Abean2k/Wiz-lite/WizLite_Production/WizLite_V1_bom.csv

Designator | Footprint | Quantity | Value | LCSC Part #
C1, C2 | 0805 | 2 | 100n
C3, C4 | 1210 | 2 | 47uF
J1 | USB_C_Receptacle_HCTL_HC-TYPE-C-16P-01A | 1 | USB_C_Receptacle_USB2.0_16P
R1, R10, R11, R2, R3, R4, R7, R8, R9 | 0805 | 9 | 10k
R12, R13 | 0805 | 2 | 330
R5, R6 | 0805 | 2 | 5.1k
SW1, SW2, SW3, SW4, SW5, SW6, SW7, SW8, SW9 | SW_SPST_TS-1088-xR020 | 9 | SW_Push
TP1, TP2, TP3, TP4 | TestPoint_Pad_D1.0mm | 4 | TestPoint
U1 | SOIC-16_3.9x9.9mm_P1.27mm | 1 | CH552G
U10, U100, U101, U102, U103, U104, U105, U106, U107, U108, U109, U11, U110, U111, U112, U113, U114, U115, U116, U117, U118, U119, U12, U120, U121, U122, U123, U124, U125, U126, U127, U13, U14, U15, U16, U17, U18, U19, U2, U20, U21, U22, U23, U24, U25, U26, U27, U28, U29, U3, U30, U31, U32, U33, U34, U35, U36, U37, U38, U39, U4, U40, U41, U42, U43, U44, U45, U46, U47, U48, U49, U5, U50, U51, U52, U53, U54, U55, U56, U57, U58, U59, U6, U60, U61, U62, U63, U64, U65, U66, U67, U68, U69, U7, U70, U71, U72, U73, U74, U75, U76, U77, U78, U79, U8, U80, U81, U82, U83, U84, U85, U86, U87, U88, U89, U9, U90, U91, U92, U93, U94, U95, U96, U97, U98, U99 | LED-SMD_4P-L2.0-W1.8_XL-0807RGBC-WS2812B-S | 126 | XL-0807RGBC-WS2812B-S | C41413181
