Abean2k/Wiz-lite/WizLite PCB/WizLite.kicad_pcb

## KiCad design WizLite PCB/WizLite.kicad_pcb (2026-10-24)

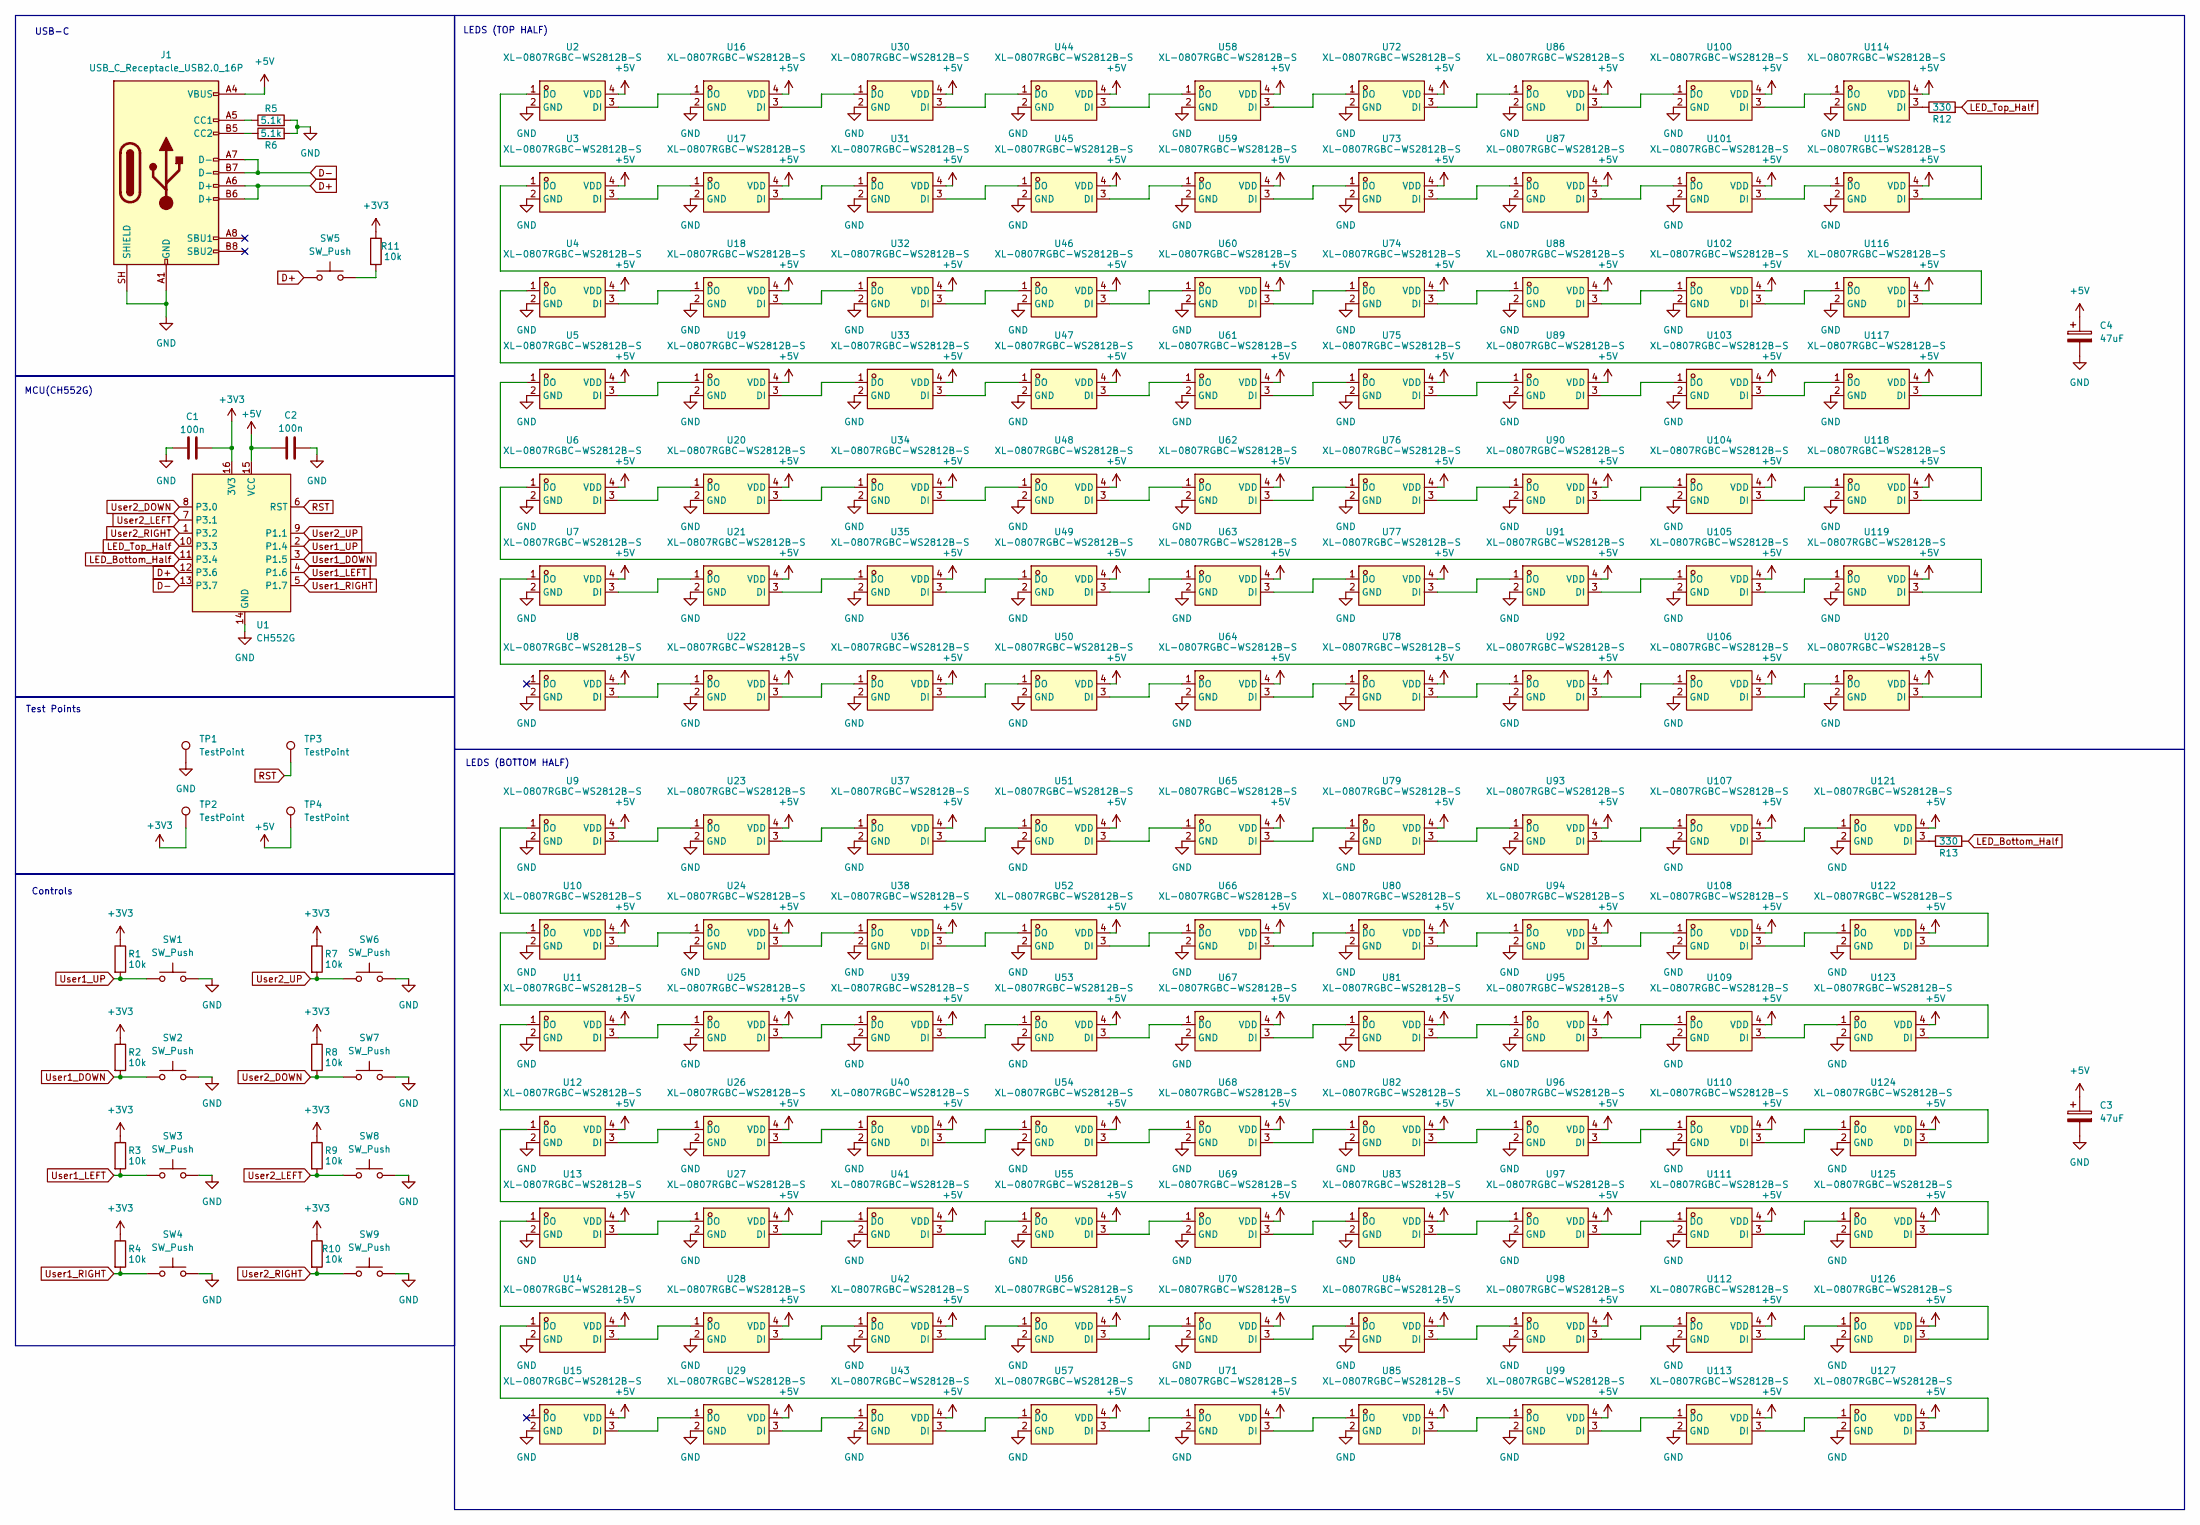
[picture p1: schematic WizLite.kicad_sch]

Parts:
C1, C2: 100n; C_0805_2012Metric_Pad1.18x1.45mm_HandSolder
C3, C4: 47uF; C_1210_3225Metric_Pad1.33x2.70mm_HandSolder
J1: USB_C_Receptacle_USB2.0_16P; USB_C_Receptacle_HCTL_HC-TYPE-C-16P-01A
R1, R2, R3, R4, R7, R8, R9, R10, R11: 10k; R_0805_2012Metric_Pad1.20x1.40mm_HandSolder
R5, R6: 5.1k; R_0805_2012Metric_Pad1.20x1.40mm_HandSolder
R12, R13: 330; R_0805_2012Metric_Pad1.20x1.40mm_HandSolder
SW1, SW2, SW3, SW4, SW5, SW6, SW7, SW8, SW9: SW_Push; SW_SPST_TS-1088-xR020
TP1, TP2, TP3, TP4: TestPoint; TestPoint_Pad_D1.0mm
U1: CH552G; SOIC-16_3.9x9.9mm_P1.27mm
U2, U3, U4, U5, U6, U7, U8, U9, U10, U11, U12, U13, U14, U15, U16, U17, U18, U19, U20, U21, U22, U23, U24, U25, U26, U27, U28, U29, U30, U31, U32, U33, U34, U35, U36, U37, U38, U39, U40, U41, U42, U43, U44, U45, U46, U47, U48, U49, U50, U51, U52, U53, U54, U55, U56, U57, U58, U59, U60, U61, U62, U63, U64, U65, U66, U67, U68, U69, U70, U71, U72, U73, U74, U75, U76, U77, U78, U79, U80, U81, U82, U83, U84, U85, U86, U87, U88, U89, U90, U91, U92, U93, U94, U95, U96, U97, U98, U99, U100, U101, U102, U103, U104, U105, U106, U107, U108, U109, U110, U111, U112, U113, U114, U115, U116, U117, U118, U119, U120, U121, U122, U123, U124, U125, U126, U127: XL-0807RGBC-WS2812B-S; LED-SMD_4P-L2.0-W1.8_XL-0807RGBC-WS2812B-S; MPN XL-0807RGBC-2812B-S; LCSC Part C41413181

Connections:
+3V3: C1.1, R1.1, R2.1, R3.1, R4.1, R7.1, R8.1, R9.1, R10.1, R11.1, TP2.1 (1_1), U1.16 (3V3)
+5V: C2.2, C3.1, C4.1, J1.A4 (VBUS), J1.A9 (VBUS), J1.B4 (VBUS), J1.B9 (VBUS), TP4.1 (1_1), U1.15 (VCC), U2.4 (VDD), U3.4 (VDD), U4.4 (VDD), U5.4 (VDD), U6.4 (VDD), U7.4 (VDD), U8.4 (VDD), U9.4 (VDD), U10.4 (VDD), U11.4 (VDD), U12.4 (VDD), U13.4 (VDD), U14.4 (VDD), U15.4 (VDD), U16.4 (VDD), U17.4 (VDD), U18.4 (VDD), U19.4 (VDD), U20.4 (VDD), U21.4 (VDD), U22.4 (VDD), U23.4 (VDD), U24.4 (VDD), U25.4 (VDD), U26.4 (VDD), U27.4 (VDD), U28.4 (VDD), U29.4 (VDD), U30.4 (VDD), U31.4 (VDD), U32.4 (VDD), U33.4 (VDD), U34.4 (VDD), U35.4 (VDD), U36.4 (VDD), U37.4 (VDD), U38.4 (VDD), U39.4 (VDD), U40.4 (VDD), U41.4 (VDD), U42.4 (VDD), U43.4 (VDD), U44.4 (VDD), U45.4 (VDD), U46.4 (VDD), U47.4 (VDD), U48.4 (VDD), U49.4 (VDD), U50.4 (VDD), U51.4 (VDD), U52.4 (VDD), U53.4 (VDD), U54.4 (VDD), U55.4 (VDD), U56.4 (VDD), U57.4 (VDD), U58.4 (VDD), U59.4 (VDD), U60.4 (VDD), U61.4 (VDD), U62.4 (VDD), U63.4 (VDD), U64.4 (VDD), U65.4 (VDD), U66.4 (VDD), U67.4 (VDD), U68.4 (VDD), U69.4 (VDD), U70.4 (VDD), U71.4 (VDD), U72.4 (VDD), U73.4 (VDD), U74.4 (VDD), U75.4 (VDD), U76.4 (VDD), U77.4 (VDD), U78.4 (VDD), U79.4 (VDD), U80.4 (VDD), U81.4 (VDD), U82.4 (VDD), U83.4 (VDD), U84.4 (VDD), U85.4 (VDD), U86.4 (VDD), U87.4 (VDD), U88.4 (VDD), U89.4 (VDD), U90.4 (VDD), U91.4 (VDD), U92.4 (VDD), U93.4 (VDD), U94.4 (VDD), U95.4 (VDD), U96.4 (VDD), U97.4 (VDD), U98.4 (VDD), U99.4 (VDD), U100.4 (VDD), U101.4 (VDD), U102.4 (VDD), U103.4 (VDD), U104.4 (VDD), U105.4 (VDD), U106.4 (VDD), U107.4 (VDD), U108.4 (VDD), U109.4 (VDD), U110.4 (VDD), U111.4 (VDD), U112.4 (VDD), U113.4 (VDD), U114.4 (VDD), U115.4 (VDD), U116.4 (VDD), U117.4 (VDD), U118.4 (VDD), U119.4 (VDD), U120.4 (VDD), U121.4 (VDD), U122.4 (VDD), U123.4 (VDD), U124.4 (VDD), U125.4 (VDD), U126.4 (VDD), U127.4 (VDD)
D+: J1.A6 (D+), J1.B6 (D+), SW5.1, U1.12 (P3.6)
D-: J1.A7 (D-), J1.B7 (D-), U1.13 (P3.7)
GND: C1.2, C2.1, C3.2, C4.2, J1.A1 (GND), J1.A12 (GND), J1.B1 (GND), J1.B12 (GND), J1.SH (SHIELD), R5.2, R6.2, SW1.2, SW2.2, SW3.2, SW4.2, SW6.2, SW7.2, SW8.2, SW9.2, TP1.1 (1_1), U1.14 (GND), U2.2 (GND), U3.2 (GND), U4.2 (GND), U5.2 (GND), U6.2 (GND), U7.2 (GND), U8.2 (GND), U9.2 (GND), U10.2 (GND), U11.2 (GND), U12.2 (GND), U13.2 (GND), U14.2 (GND), U15.2 (GND), U16.2 (GND), U17.2 (GND), U18.2 (GND), U19.2 (GND), U20.2 (GND), U21.2 (GND), U22.2 (GND), U23.2 (GND), U24.2 (GND), U25.2 (GND), U26.2 (GND), U27.2 (GND), U28.2 (GND), U29.2 (GND), U30.2 (GND), U31.2 (GND), U32.2 (GND), U33.2 (GND), U34.2 (GND), U35.2 (GND), U36.2 (GND), U37.2 (GND), U38.2 (GND), U39.2 (GND), U40.2 (GND), U41.2 (GND), U42.2 (GND), U43.2 (GND), U44.2 (GND), U45.2 (GND), U46.2 (GND), U47.2 (GND), U48.2 (GND), U49.2 (GND), U50.2 (GND), U51.2 (GND), U52.2 (GND), U53.2 (GND), U54.2 (GND), U55.2 (GND), U56.2 (GND), U57.2 (GND), U58.2 (GND), U59.2 (GND), U60.2 (GND), U61.2 (GND), U62.2 (GND), U63.2 (GND), U64.2 (GND), U65.2 (GND), U66.2 (GND), U67.2 (GND), U68.2 (GND), U69.2 (GND), U70.2 (GND), U71.2 (GND), U72.2 (GND), U73.2 (GND), U74.2 (GND), U75.2 (GND), U76.2 (GND), U77.2 (GND), U78.2 (GND), U79.2 (GND), U80.2 (GND), U81.2 (GND), U82.2 (GND), U83.2 (GND), U84.2 (GND), U85.2 (GND), U86.2 (GND), U87.2 (GND), U88.2 (GND), U89.2 (GND), U90.2 (GND), U91.2 (GND), U92.2 (GND), U93.2 (GND), U94.2 (GND), U95.2 (GND), U96.2 (GND), U97.2 (GND), U98.2 (GND), U99.2 (GND), U100.2 (GND), U101.2 (GND), U102.2 (GND), U103.2 (GND), U104.2 (GND), U105.2 (GND), U106.2 (GND), U107.2 (GND), U108.2 (GND), U109.2 (GND), U110.2 (GND), U111.2 (GND), U112.2 (GND), U113.2 (GND), U114.2 (GND), U115.2 (GND), U116.2 (GND), U117.2 (GND), U118.2 (GND), U119.2 (GND), U120.2 (GND), U121.2 (GND), U122.2 (GND), U123.2 (GND), U124.2 (GND), U125.2 (GND), U126.2 (GND), U127.2 (GND)
LED_Bottom_Half: R13.2, U1.11 (P3.4)
LED_Top_Half: R12.2, U1.10 (P3.3)
unnamed: J1.A5 (CC1), R5.1
unnamed: J1.B5 (CC2), R6.1
unnamed: R11.2, SW5.2
unnamed: U10.3 (DI), U24.1 (DO)
unnamed: U10.1 (DO), U123.3 (DI)
unnamed: U11.3 (DI), U25.1 (DO)
unnamed: U11.1 (DO), U124.3 (DI)
unnamed: U12.3 (DI), U26.1 (DO)
unnamed: U12.1 (DO), U125.3 (DI)
unnamed: U13.3 (DI), U27.1 (DO)
unnamed: U14.3 (DI), U28.1 (DO)
unnamed: U15.3 (DI), U29.1 (DO)
unnamed: U16.3 (DI), U30.1 (DO)
unnamed: U2.3 (DI), U16.1 (DO)
unnamed: U17.3 (DI), U31.1 (DO)
unnamed: U3.3 (DI), U17.1 (DO)
unnamed: U18.3 (DI), U32.1 (DO)
unnamed: U4.3 (DI), U18.1 (DO)
unnamed: U19.3 (DI), U33.1 (DO)
unnamed: U5.3 (DI), U19.1 (DO)
unnamed: U20.3 (DI), U34.1 (DO)
unnamed: U6.3 (DI), U20.1 (DO)
unnamed: U21.3 (DI), U35.1 (DO)
unnamed: U7.3 (DI), U21.1 (DO)
unnamed: U22.3 (DI), U36.1 (DO)
unnamed: U8.3 (DI), U22.1 (DO)
unnamed: U23.3 (DI), U37.1 (DO)
unnamed: U9.3 (DI), U23.1 (DO)
unnamed: U24.3 (DI), U38.1 (DO)
unnamed: U25.3 (DI), U39.1 (DO)
unnamed: U26.3 (DI), U40.1 (DO)
unnamed: U27.3 (DI), U41.1 (DO)
unnamed: U28.3 (DI), U42.1 (DO)
unnamed: U29.3 (DI), U43.1 (DO)
unnamed: U30.3 (DI), U44.1 (DO)
unnamed: U31.3 (DI), U45.1 (DO)
unnamed: U32.3 (DI), U46.1 (DO)
unnamed: U33.3 (DI), U47.1 (DO)
unnamed: U34.3 (DI), U48.1 (DO)
unnamed: U35.3 (DI), U49.1 (DO)
unnamed: U36.3 (DI), U50.1 (DO)
unnamed: U37.3 (DI), U51.1 (DO)
unnamed: U38.3 (DI), U52.1 (DO)
unnamed: U39.3 (DI), U53.1 (DO)
unnamed: U40.3 (DI), U54.1 (DO)
unnamed: U41.3 (DI), U55.1 (DO)
unnamed: U42.3 (DI), U56.1 (DO)
unnamed: U43.3 (DI), U57.1 (DO)
unnamed: U44.3 (DI), U58.1 (DO)
unnamed: U45.3 (DI), U59.1 (DO)
unnamed: U46.3 (DI), U60.1 (DO)
unnamed: U47.3 (DI), U61.1 (DO)
unnamed: U48.3 (DI), U62.1 (DO)
unnamed: U49.3 (DI), U63.1 (DO)
unnamed: U50.3 (DI), U64.1 (DO)
unnamed: U51.3 (DI), U65.1 (DO)
unnamed: U52.3 (DI), U66.1 (DO)
unnamed: U53.3 (DI), U67.1 (DO)
unnamed: U54.3 (DI), U68.1 (DO)
unnamed: U55.3 (DI), U69.1 (DO)
unnamed: U56.3 (DI), U70.1 (DO)
unnamed: U57.3 (DI), U71.1 (DO)
unnamed: U58.3 (DI), U72.1 (DO)
unnamed: U59.3 (DI), U73.1 (DO)
unnamed: U60.3 (DI), U74.1 (DO)
unnamed: U61.3 (DI), U75.1 (DO)
unnamed: U62.3 (DI), U76.1 (DO)
unnamed: U63.3 (DI), U77.1 (DO)
unnamed: U64.3 (DI), U78.1 (DO)
unnamed: U65.3 (DI), U79.1 (DO)
unnamed: U66.3 (DI), U80.1 (DO)
unnamed: U67.3 (DI), U81.1 (DO)
unnamed: U68.3 (DI), U82.1 (DO)
unnamed: U69.3 (DI), U83.1 (DO)
unnamed: U70.3 (DI), U84.1 (DO)
unnamed: U71.3 (DI), U85.1 (DO)
unnamed: U72.3 (DI), U86.1 (DO)
unnamed: U73.3 (DI), U87.1 (DO)
unnamed: U74.3 (DI), U88.1 (DO)
unnamed: U75.3 (DI), U89.1 (DO)
unnamed: U76.3 (DI), U90.1 (DO)
unnamed: U77.3 (DI), U91.1 (DO)
unnamed: U78.3 (DI), U92.1 (DO)
unnamed: U79.3 (DI), U93.1 (DO)
unnamed: U80.3 (DI), U94.1 (DO)
unnamed: U81.3 (DI), U95.1 (DO)
unnamed: U82.3 (DI), U96.1 (DO)
unnamed: U83.3 (DI), U97.1 (DO)
unnamed: U84.3 (DI), U98.1 (DO)
unnamed: U85.3 (DI), U99.1 (DO)
unnamed: U100.3 (DI), U114.1 (DO)
unnamed: U86.3 (DI), U100.1 (DO)
unnamed: U101.3 (DI), U115.1 (DO)
unnamed: U87.3 (DI), U101.1 (DO)
unnamed: U102.3 (DI), U116.1 (DO)
unnamed: U88.3 (DI), U102.1 (DO)
unnamed: U103.3 (DI), U117.1 (DO)
unnamed: U89.3 (DI), U103.1 (DO)
unnamed: U104.3 (DI), U118.1 (DO)
unnamed: U90.3 (DI), U104.1 (DO)
unnamed: U105.3 (DI), U119.1 (DO)
unnamed: U91.3 (DI), U105.1 (DO)
unnamed: U106.3 (DI), U120.1 (DO)
unnamed: U92.3 (DI), U106.1 (DO)
unnamed: U107.3 (DI), U121.1 (DO)
unnamed: U93.3 (DI), U107.1 (DO)
unnamed: U108.3 (DI), U122.1 (DO)
unnamed: U94.3 (DI), U108.1 (DO)
unnamed: U109.3 (DI), U123.1 (DO)
unnamed: U95.3 (DI), U109.1 (DO)
unnamed: U110.3 (DI), U124.1 (DO)
unnamed: U96.3 (DI), U110.1 (DO)
unnamed: U111.3 (DI), U125.1 (DO)
unnamed: U97.3 (DI), U111.1 (DO)
unnamed: U112.3 (DI), U126.1 (DO)
unnamed: U98.3 (DI), U112.1 (DO)
unnamed: U113.3 (DI), U127.1 (DO)
unnamed: U99.3 (DI), U113.1 (DO)
unnamed: R12.1, U114.3 (DI)
unnamed: U2.1 (DO), U115.3 (DI)
unnamed: U3.1 (DO), U116.3 (DI)
unnamed: U4.1 (DO), U117.3 (DI)
unnamed: U5.1 (DO), U118.3 (DI)
unnamed: U6.1 (DO), U119.3 (DI)
unnamed: U7.1 (DO), U120.3 (DI)
unnamed: R13.1, U121.3 (DI)
unnamed: U9.1 (DO), U122.3 (DI)
unnamed: U13.1 (DO), U126.3 (DI)
unnamed: U14.1 (DO), U127.3 (DI)
RST: TP3.1 (1_1), U1.6 (RST)
User1_DOWN: R2.2, SW2.1, U1.3 (P1.5)
User1_LEFT: R3.2, SW3.1, U1.4 (P1.6)
User1_RIGHT: R4.2, SW4.1, U1.5 (P1.7)
User1_UP: R1.2, SW1.1, U1.2 (P1.4)
User2_DOWN: R8.2, SW7.1, U1.8 (P3.0)
User2_LEFT: R9.2, SW8.1, U1.7 (P3.1)
User2_RIGHT: R10.2, SW9.1, U1.1 (P3.2)
User2_UP: R7.2, SW6.1, U1.9 (P1.1)

Notes on the sheet:
MCU(CH552G)
Controls
USB-C
LEDS (BOTTOM HALF)
Test Points
LEDS (TOP HALF)

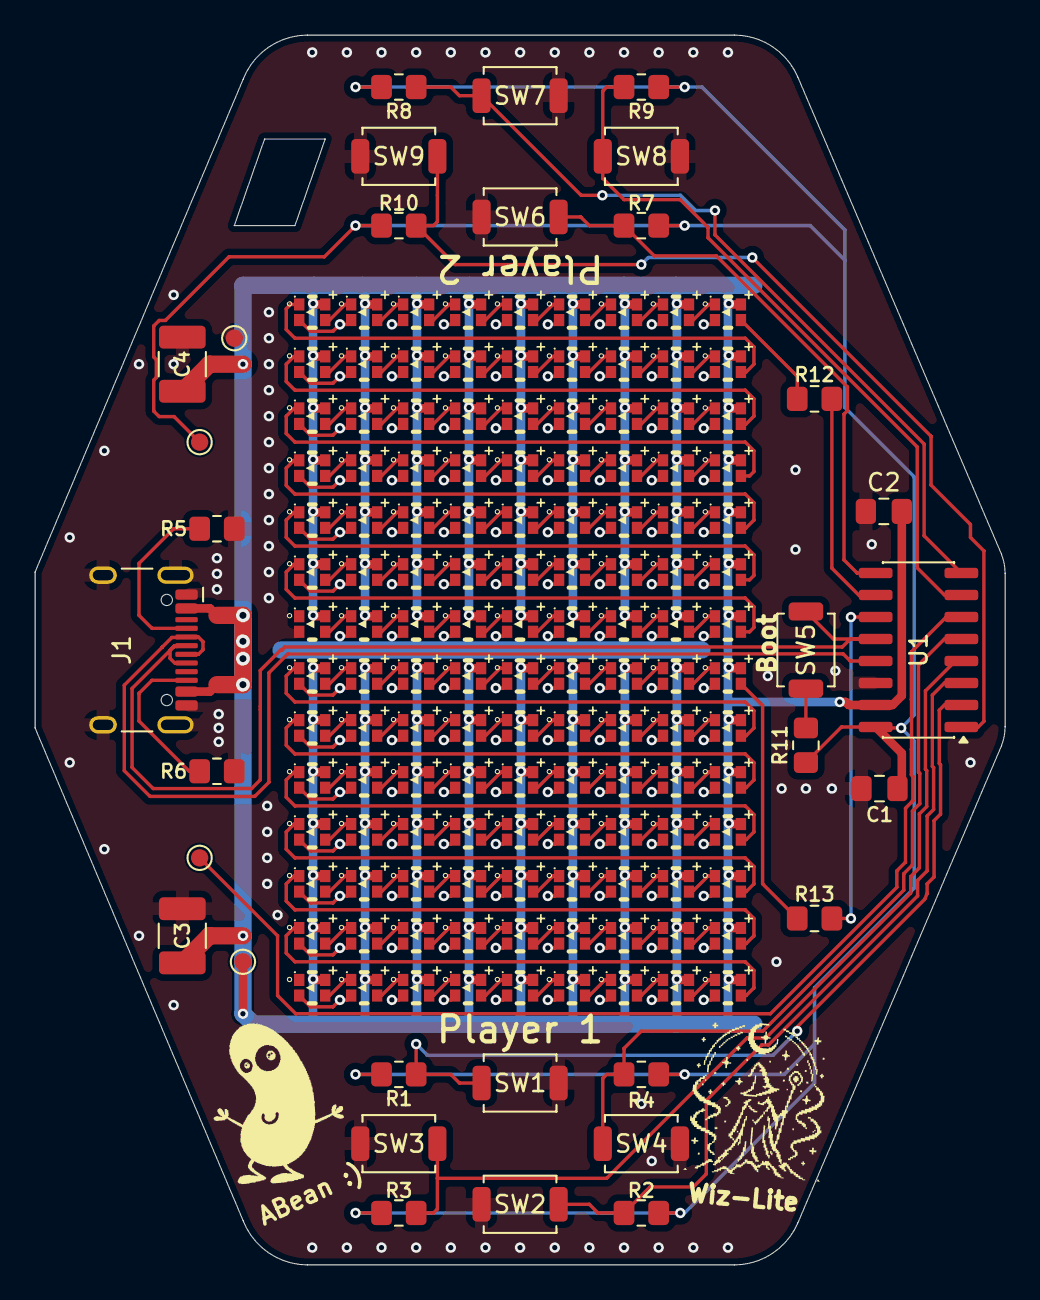
[picture p2: board WizLite.kicad_pcb from above]

Board: 2 copper layers, 56.0 x 71.0 mm, 158 parts (0 on the bottom side), 145 nets.
