Abean2k/Wiz-lite/WizLite Code/PictureMaker.html

# WizLite - Picture Maker

Make a 9 x 14 picture for the game console, either by importing a Figma screenshot or by drawing it.
Any colors you like: every picture carries its own color list, so there is nothing to set up in the firmware.

### 1. Import (optional)

or drag a file onto the page, or Ctrl+V to paste

Load a screenshot, then drag a box around ONE 9 x 14 picture.

Background:

Near-black pixels become a white LED (for Figma letters)

Merge similar colors: 40

Higher merges more shades into one color. Changing the picture area or these settings redoes the conversion (and replaces what you drew).

### 2. Draw / fix

Paint Erase Clear all

Click or drag on the squares. Paint uses the selected color on the right.

Simulate console brightness (BRIGHTNESS in WizBase.c)

### Colors (1 of 62)

0#ffffff×

+ Add color

Click a color to select it. Click its square to change it: every pixel using it changes too.
Unused colors are left out of the code automatically.

### 3. Code

Name

Game cover (goes in your game's .c file)
Shared screen (goes in WizBase.c)

Paste the .c code at the TOP of your game's .c file (after its #includes), and the .h line into your game's .h file. Then add { &picMyGameCover, playYourGame } to games[] in WizGameLite.ino.

Flash used: 130 bytes (126 pixels + 3 per color + 4 pointers). No RAM.

Paste into the .c file Copy

Paste into the .h file Copy

This picture maker was vibecoded by Claude Sonnet 5.5.
