Abean2k/Wiz-lite/WizLite Code/WizLite/Snake.h

#ifndef SNAKE_H
#define SNAKE_H

#include "WizBase.h"

extern __code const Picture picSnakeCover;   // shown in the game carousel

void playSnake(void);   // returns when the game is over or the player holds the exit buttons

#endif
