Abean2k/Wiz-lite/(commit log)

2026-10-24 Added PCB Art & Added Production Files
    [GameWizLite.kicad_sch, WizLite.kicad_pcb, WizLite.kicad_sch, WizLite_V1_bom.csv, WizLite_V1_designators.csv, WizLite_V1_positions.csv]
2026-10-26 Enhance README with project details and images
    Expanded the README to include detailed project design, PCB information, and schematic/layout images.
2026-10-26 Enhance README with firmware and game details
    Expanded the README to include details about firmware, games, and the PictureMaker tool. Added sections on assembly and how the project works
2026-10-26 Update README with BOM and cost details
    Added BOM section with parts and pricing details.
2026-11-02 Add links to BOM parts in README
    Updated BOM table to include links for each part.
2026-11-02 Added BOM.csv
    [BOM.csv]
2026-11-02 Enhance README with PCB assembly recommendations
    Expanded the assembly section with recommendations for PCB ordering and assembly options.
